tuxede/boost-converter/board_boost_conv.png

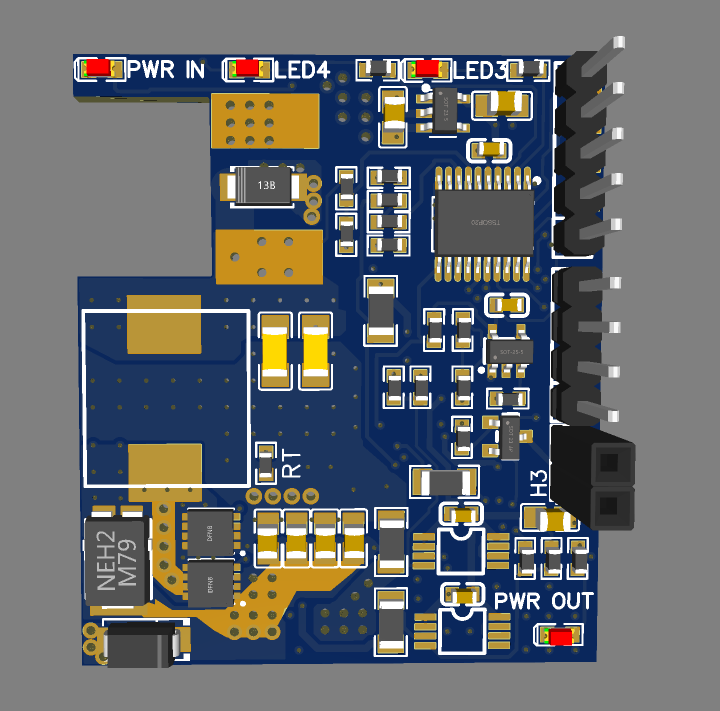
board_boost_conv.png
