tuxede/boost-converter/pcb_boost_conv.png

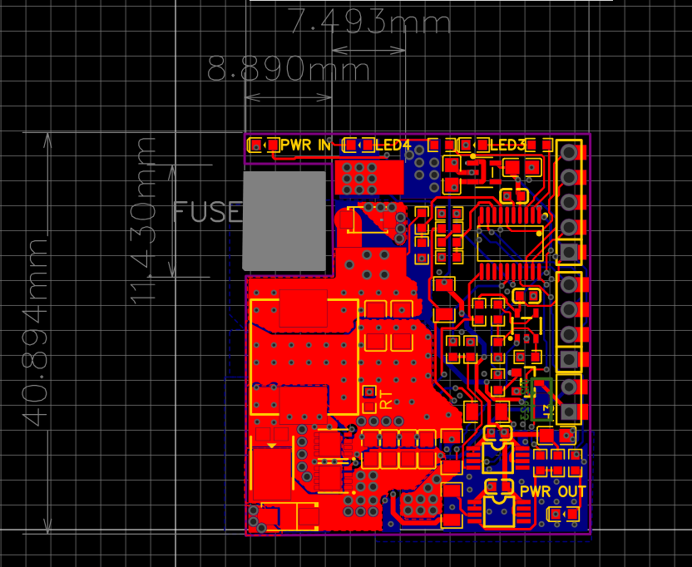
pcb_boost_conv.png
