tuxede/boost-converter/Schematic_1s-18650-step-up_2024-09-11.pdf

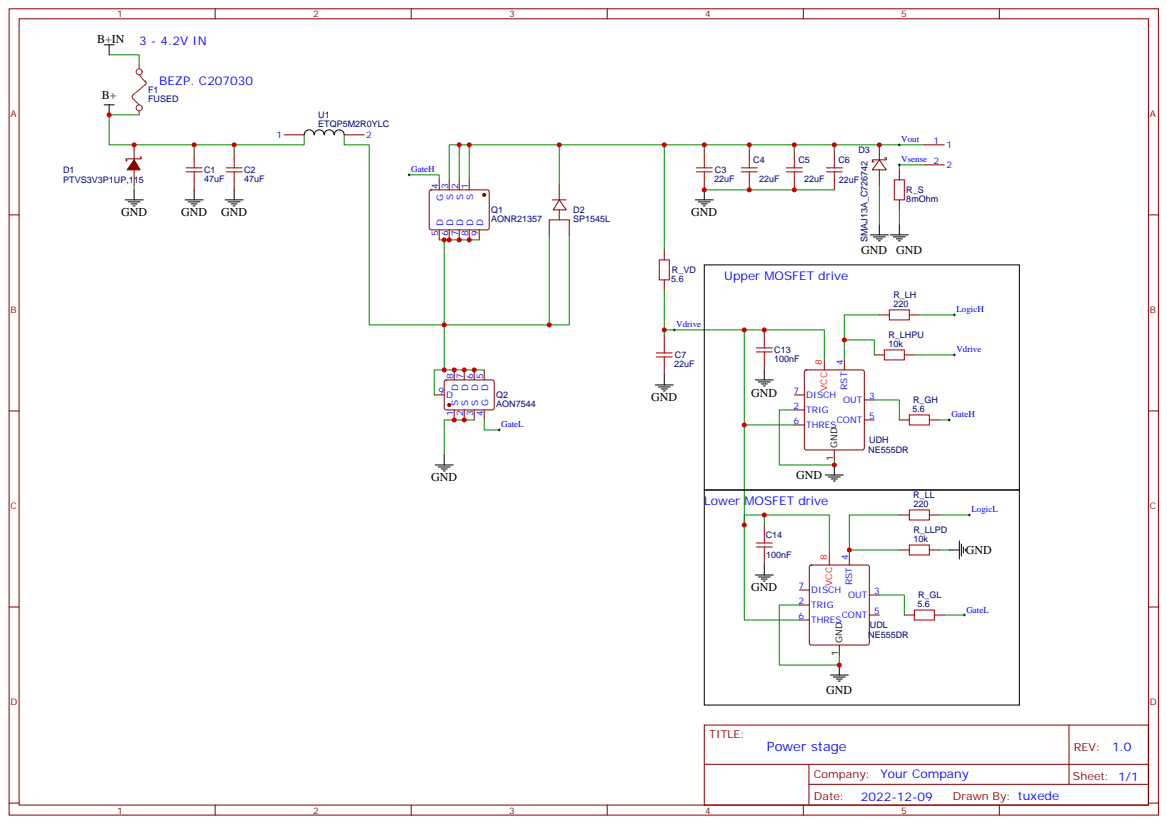
[picture p3: page 1]

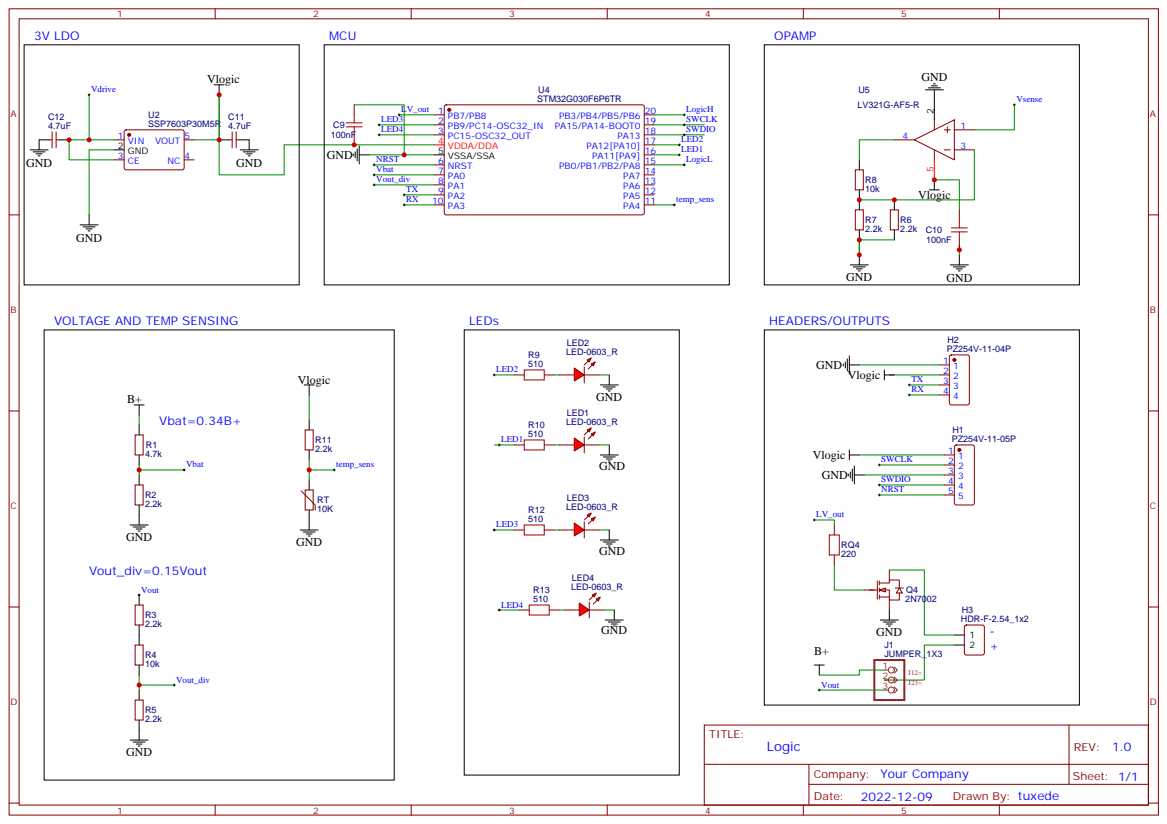
[picture p4: page 2]
