tuxede/boost-converter/boost 1s.asc

C1: cap; 22µ; V=16 Irms=13.8 Rser=0.00468332 Lser=0
C2: cap; 22µ; V=16 Irms=13.8 Rser=0.00468332 Lser=0
C3: cap; 22µ; V=16 Irms=13.8 Rser=0.00468332 Lser=0
C4: cap; 22µ; V=16 Irms=13.8 Rser=0.00468332 Lser=0
C5: cap; 22µ
C6: cap; 47µ; V=16 Irms=0 Rser=0.00225907 Lser=900p mfg="Würth Elektronik" pn="885012109011 WCAP-CSGP 1210" type="X5R"
C7: cap; 47µ; V=16 Irms=0 Rser=0.00225907 Lser=900p mfg="Würth Elektronik" pn="885012109011 WCAP-CSGP 1210" type="X5R"
I1: current; 6
L1: ind; 2.5µ; Ipk=25.5 Rser=0.00402 Rpar=0 Cpar=0
M1: nmos; CSD17506Q5A
M2: pmos; AONR21357
R1: res; 5
R2: res; 5
R3: res; 200
R4: res; 200
R5: res; 0.001
R6: res; 10k
R7: res; 200
R8: res; 5k
R9: res; 8m
R10: res; 1.1k
R11: res; 20k
R12: res; 2.2k
R14: res; 5
R15: res; 10k
U1: NE555
U2: NE555
U3: LT1677
V1: voltage; 4; Rser=40m
V2: voltage; PULSE(0 5 200.38u 100n 100n 6.6u 10u)
V3: voltage; PULSE(0 20 6.12u 100n 100n 2.7u 9u)
V4: voltage; PULSE(0 5 200u 100n 100n 7u 10u)
Named nets: 0, Vout, Vf, Vgate, P_src, Vin, Vdrive
.tran 0 3m 2m
