tuxede/boost-converter/(commit log)

2024-09-11 pcb overview
2024-09-11 board overview
